modulo-/SDP-2016-Team-F/doc/group12/TechSpec/Arduino.tex

\section{Arduino Software}
\subsection{Main Loop}
The main loop listens on the serial port and executes any command received in a non-blocking manner. 
\subsection{Command Set}
The commands are as follows:\\
kick(distance)\\
grab()\\
release()\\
turn(angle)\\
move(distance)\\
\subsection{Command Response}
In response to a command the robot immediately drops what it is doing and runs that command. 
\subsection{Kicking}
The robot aligns the ball with the grabbers then releases them until they are at position 0 (fully extended) then kicks a time dependent on the distance required, then closes the grabbers to position 13 (fully closed) for continued movement. The formula for kick time in ms used by the arduino is $ 1.3*(D-46) $ where D is distance required in cm. 
\subsection{Grabbing}
The robot closes the grabbers until they are fully closed or 800ms whichever is sooner, if the grabbers only close to position 10 the grab is considered a success and this is sent to the planner. 
On success: reply "BC"
On failure: reply "NC"
\subsection{Release}
The grabbers are released to position 0. The reply "grabbersOpen" is always sent. 
\subsection{Turn}
The robot accelerates up to a calibrated turning speed, then maintains that speed until it has just enough time to decelerate to the required position. The wheels are kept turning the same distance using the distance from the rotary encoders by powering down a motor if it has gone too far and powering it up if it has not gone far enough. The turn is considered finished when the averaged distance from the left and right wheels matches the calculated distance required to rotate the desired angle (by using radius of wheels:2.5cm, radius from origin:7.5cm). 
\subsection{Move}
The robot accelerates up to the calibrated speed and then maintains that speed until it has just enough time to decelerate to the desired distance. It keeps the wheels going the same distance using the rotary encoders by reducing power to a wheel that has gone too far. The distance is determined by the
 $\texttt{radius of the wheels} \times \pi \times \texttt{rotation}$.
