modulo-/SDP-2016-Team-F/doc/group11/tech_spec/main.tex

\documentclass[a4paper,12pt]{scrartcl}
\author{Thomas Kerber, Marek Strelec, Euan Hunter}
\title{SDP Technical Specification}
\subtitle{Group 11}

\usepackage[margin=3.4cm]{geometry}
\usepackage{array}
\usepackage{tabularx}
\usepackage{enumitem}
\usepackage{paralist,array}
\usepackage{listings}
\usepackage{cleveref}
\usepackage{graphicx}
\usepackage{float}
\usepackage{caption}
\usepackage{subcaption}
\usepackage{gensymb}
\lstset{language=Python, showstringspaces=false}

\begin{document}
\maketitle

\section{Introduction}

The aim of this project was to create a robot that would play a simplified
version of 2-a-side football. We used the provided Arduino Xino RF board and
LEGO pieces, a vision feed of the pitch, and a computer to connect Arduino and
vision. This report will examine the decisions made in the design of each part
and their impacts.

\input{overview}
\input{comms}
\input{arduino}
\input{hardware}
\input{vision}

\pagebreak
\input{planner}

\pagebreak
\appendix

\input{abi}
\input{llcmd}
\input{params}
\input{goalstructure}

\end{document}
