modulo-/SDP-2016-Team-F/admin/2016-02-22.md

note that the axes should be short axis -y long axis -x and angles should be clockwise from y
people should be careful to switch to master 
blue distortion at edge of vision feed is a priority 
everyone should get a draft of their section of the reports
