modulo-/SDP-2016-Team-F/admin/expenses.md

# Expenses Group 11

| Item | Cost  | Funds From |
|--- |:----: | ---|
| | | |

Total: £0
Budget left: £100 

# Expenses Group 12

| Item | Cost  | Funds From |
|--- |:----: | ---|
| 2 Keys | £5 | Margus |
| Wheels | ??? | Garry | 
| battery holders | £5.02 | Joel | 

Total: £10.02
Budget left: £89.98
