modulo-/SDP-2016-Team-F/doc/group12/TechSpec/obstacle_avoidance.tex

\begin{tikzpicture}
  
\tikzset{
    right angle quadrant/.code={
        \pgfmathsetmacro\quadranta{{1,1,-1,-1}[#1-1]}     % Arrays for selecting quadrant
        \pgfmathsetmacro\quadrantb{{1,-1,-1,1}[#1-1]}},
    right angle quadrant=1, % Make sure it is set, even if not called explicitly
    right angle length/.code={\def\rightanglelength{#1}},   % Length of symbol
    right angle length=2ex, % Make sure it is set...
    right angle symbol/.style n args={3}{
        insert path={
            let \p0 = ($(#1)!(#3)!(#2)$) in     % Intersection
                let \p1 = ($(\p0)!\quadranta*\rightanglelength!(#3)$), % Point on base line
                \p2 = ($(\p0)!\quadrantb*\rightanglelength!(#2)$) in % Point on perpendicular line
                let \p3 = ($(\p1)+(\p2)-(\p0)$) in  % Corner point of symbol
            (\p1) -- (\p3) -- (\p2)
        }
    }
}

\node  (robot)  [draw, inner sep=5] at (0,-1) {ROBOT};
\node  (target)  [draw,inner sep=5] at (0,5) {TARGET};
\draw  (robot) [dotted, -open triangle 60] edge node [sloped, below left ]{original path} (target);

\node (obstacle)[draw] at (1,3) {$O_2$};
\draw [dashed, shorten >=-1.5cm,shorten <=-2.5cm] ($(robot)!(obstacle)!(target)$) -- (obstacle);

\draw [right angle symbol={robot}{$(robot)!(obstacle)!(target)$}{obstacle}];
\coordinate (new) at (-1.5,3) {};

\path (robot) [-triangle 60] edge node [sloped,below] {corrected path} (new)
(new) [-triangle 60] edge (target);

\draw[decorate,decoration={brace,raise=2pt,amplitude=2pt}] (obstacle)  -- node[below=3pt]{$d_{min}$} (new) ;

\end{tikzpicture}
