modulo-/SDP-2016-Team-F/doc/group12/TechSpec/Planning.tex

\section{Planning}
\lstset{language=Python, showstringspaces=false}

\subsection{Design}

The planner uses a system of goals and actions. Goals define an overall strategy in a given situation leading to a particular aim. Actions define one instruction given to the robot with preconditions for its execution. Goals are composed of a sequence of actions. A goal object selects the next action required to achieve its aim by traversing its ordered list of actions and evaluating their preconditions.

In the implementation, all goals and actions are derived from their respective super classes. These are defined as follows:

\begin{figure}[H]
	\centering
    
    \caption{Definition of super class for goals}
\end{figure}

\begin{figure}[H]
	\centering
    
    \caption{Definition of super class for actions}
\end{figure}

The planner makes its decision based only on the world state passed to it. This is described by an instance of the  class passed to the planner. This object's state is updated by passing a new set of positions (as a dictionary of vectors) to the \texttt{update\_positions} method of \texttt{World}. The \texttt{World} class describes the state of the world from the vision, including position vectors for the robots, the ball, and the goals. The \texttt{World} class and its associated classes also implement methods on their data providing the planner with information about the world. Further utility functionality can be found in ``\texttt{utils.py}''

The overall planner is used by calling \texttt{plan\_and\_act(world)}.
This selects a goal based on the given world state  using its \texttt{get\_goal()} method. From this goal an action is generated using \texttt{generate\_action()}. The method then runs (using \texttt{actuate(action)}) and returns a delay giving the time until the planner should be run again.

In order to succeed, the planner must be able to detect obstacles on the path of a robot's movement and on the path of a pass or shot on goal. Having established a location and target, the planner checks for obstacles as seen in \autoref{fig:obstacle_detection}. $O_i$ is an obstacle if ($d_i > \texttt{THRESHOLD}$).

\begin{figure}[H]
\centering
\begin{subfigure}{.5\textwidth}
\centering
\input{obstacle_detection}
\caption{Detection}
\label{fig:obstacle_detection}
\end{subfigure}%
\begin{subfigure}{.5\textwidth}
\centering
\input{obstacle_avoidance}
\caption{Avoidance}
\label{fig:obstacle_avoidance}
\end{subfigure}
\caption{Handling Obstacles}
\label{handling_obstacle}
\end{figure}

By finding the distance of each object from the path and using a constant threshold, the planner establishes whether or not, and if so which, objects will be obstacles to a given path. If an obstacle is found, the planner must, if possible, generate a new path avoiding the obstacle. This is done using the line perpendicular to the path passing through the obstacle. The planner iterates over points at fixed distances along the line, working outwards from the original path, testing for obstacles on this corrected path. This produces a minimal path avoiding the obstacle. This can be seen in \autoref{fig:obstacle_avoidance}.

The planner also incorporates logic outwith this high level design for obeying specific rules, closing the robot's grabbers after a fixed time open and releasing the ball after a fixed time holding it. These work through communication with the robot and timers running alongside the main planner thread.

\subsection{Implementation}

The attacker robot's goals and their respective actions are explained in \autoref{tbl:goals-actions}.
The planner chooses a goal based on ball position, as explained in \autoref{tbl:goals}.

\begin{table}[H]
  \centering
\begin{tabularx}{\textwidth}{l l X}
\toprule
\textbf{Goal} & \textbf{Action} & \textbf{Preconditions} \\ 
\midrule

AttackPosition & TurnToDefenderToReceive & Attacker in score zone \\ 
&GoToScoreZone & Attacker is facing score zone  \\ 
&TurnToScoreZone & None \\
\midrule

Score & Shoot & Attacker has ball and attacker can score \\ 
& TurnToGoal & Attacker has ball \\ 
\midrule

GetBall & GrabBall & Attacker can catch ball and attacker's grabbers open \\ 
& GoToGrabStaticBall & Ball static, attacker facing ball, attacker's grabbers open \\ &OpenGrabbers & Ball in attacker's grab range, attacker's grabbers closed \\ 
&GoToBallOpeningDistance & Attacker is facing ball \\
&TurnToBall & None \\ 
\midrule

AttackerBlock & TurnToBlockingAngle & Attacker in blocking position \\ 
& GoToBlockingPosition & Attacker is facing blocking position \\ 
& TurnToFaceBlockingPosition & None \\ 
\bottomrule
\end{tabularx}
\caption{Actions and Preconditions by Goals}
\label{tbl:goals-actions}
\end{table}

\begin{table}[H]
\centering
\begin{tabular}{ l l}
\toprule
\textbf{Robot in possession} & \textbf{Goal} \\ \midrule
Our attacker & Score \\
Our defender & AttackPosition \\
Their attacker & AttackPosition \\
Their defender & AttackerBlock \\
Ball free & GetBall \\ \bottomrule
\end{tabular}
\caption{Goals chosen dependent on ball position}
\label{tbl:goals}
\end{table}

\subsection{Extensibility}

Extending the planner is simply a case of adding goals and actions then adding the logic to select these in \texttt{select\_goal(world)}. Any new goals or actions should subclass Goal and Action respectively and override methods were stated.

In actions, the logic for performing should be placed in \texttt{perform(comms)}. This method is passed a \texttt{CommsManager} object through which the robot can be sent instructions. No more than one call should be made to this object in any given action. A new action should also override \texttt{get\_delay} giving an appropriate delay (in seconds) before the planner should run again. New actions can also have preconditions defined in a variable \texttt{preconditions}.

In goals, it may only be neccessary to write a Goal subclass with an ordered list of actions (from last to first). Otherwise, the \texttt{generate\_action()} method can be overriden but similar logic should be followed.

\subsection{Integration}

An instance of the \texttt{Planner} is kept by the ``main.py'' script. Based on the delays given by the planner, it calls the planner at varying intervals, passing it the latest world model provided by the vision. The planner uses a \texttt{CommsManager} object to control the robot.
