modulo-/SDP-2016-Team-F/doc/group12/TechSpec/images/DSC_0033.jpg

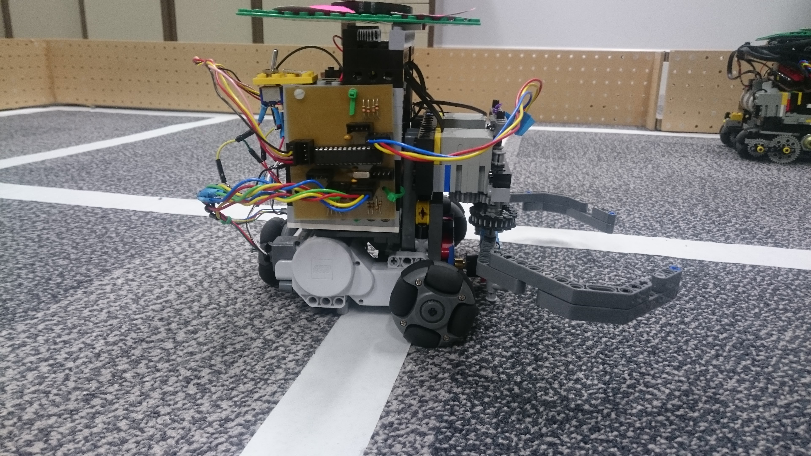
doc/group12/TechSpec/images/DSC_0033.jpg
