modulo-/SDP-2016-Team-F/doc/group12/TechSpec/images/DSC_0035.jpg

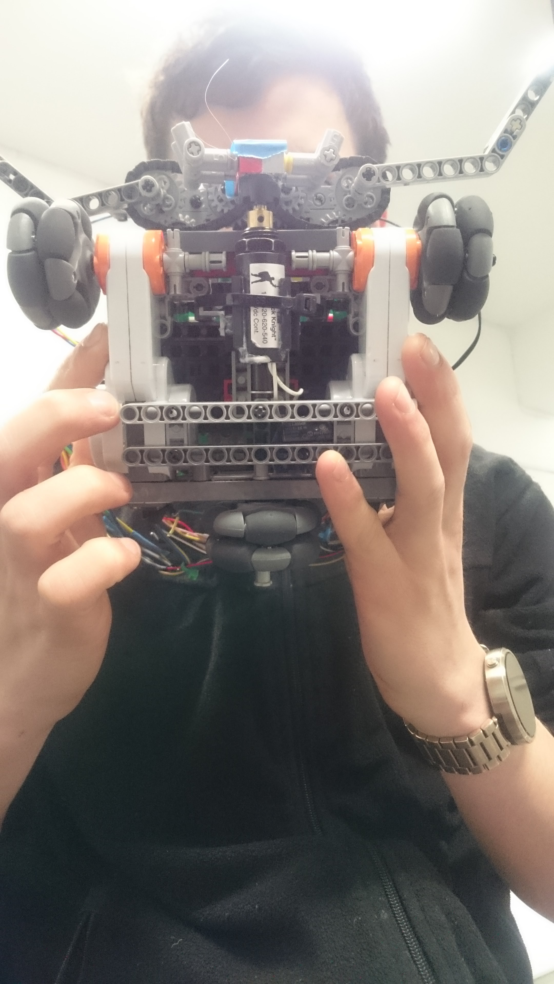
doc/group12/TechSpec/images/DSC_0035.jpg
