modulo-/SDP-2016-Team-F/doc/group12/TechSpec/images/obstacle_detection.jpg

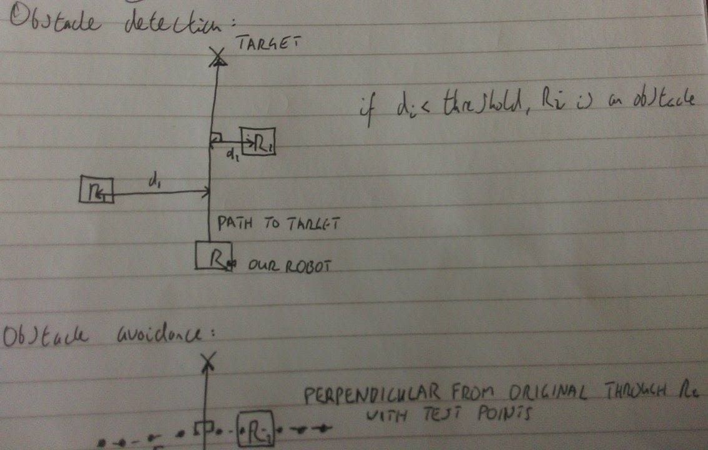
doc/group12/TechSpec/images/obstacle_detection.jpg
