modulo-/SDP-2016-Team-F/doc/group12/TechSpec/images/speed_time.png

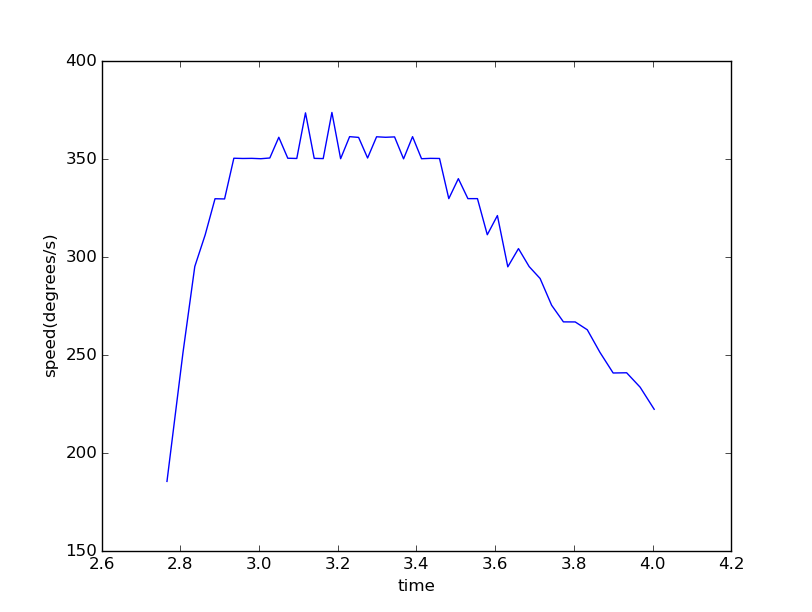
doc/group12/TechSpec/images/speed_time.png
