modulo-/SDP-2016-Team-F/plot/acceleration_time.png

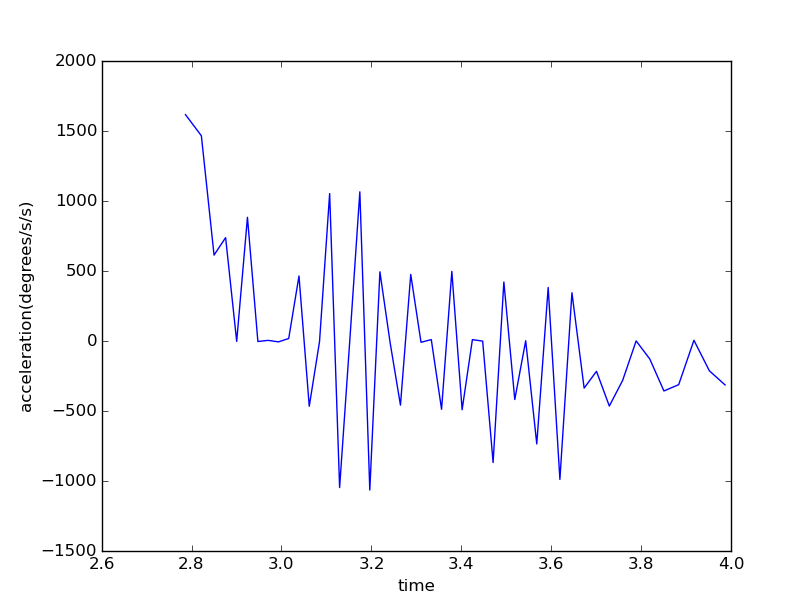
plot/acceleration_time.png
