modulo-/SDP-2016-Team-F/plot/difference_time.png

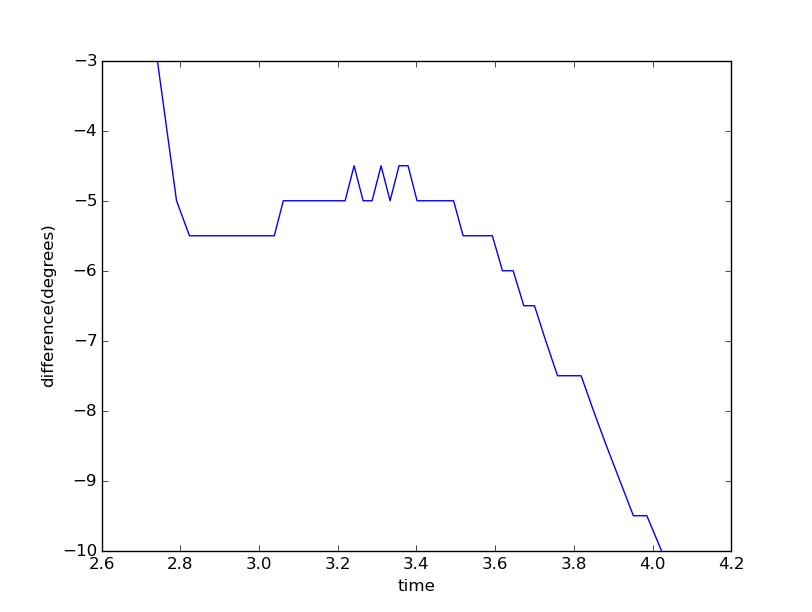
plot/difference_time.png
