modulo-/SDP-2016-Team-F/plot/distance_time.png

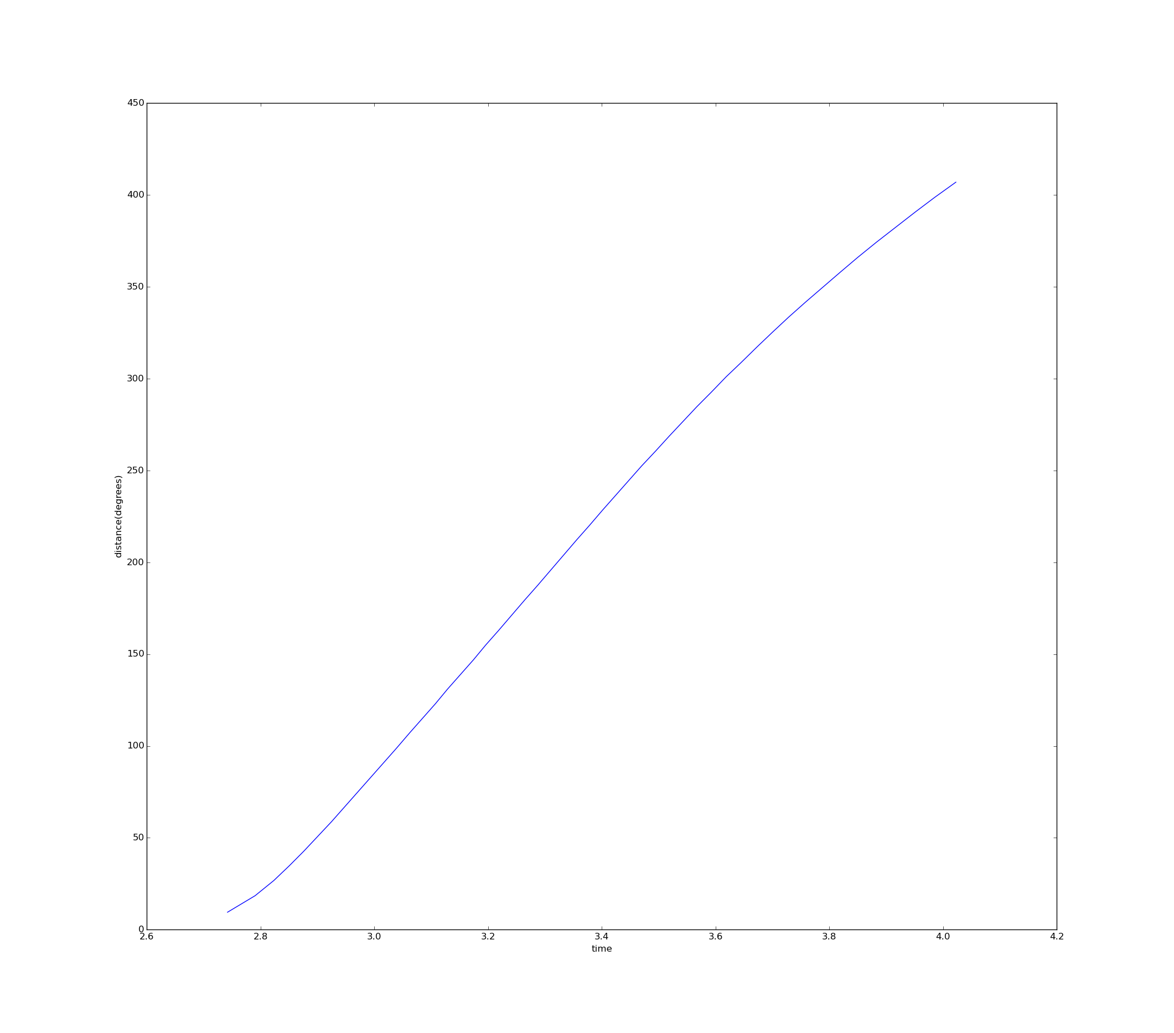
plot/distance_time.png
