modulo-/SDP-2016-Team-F/vision-euan/config/pitch303-background.png

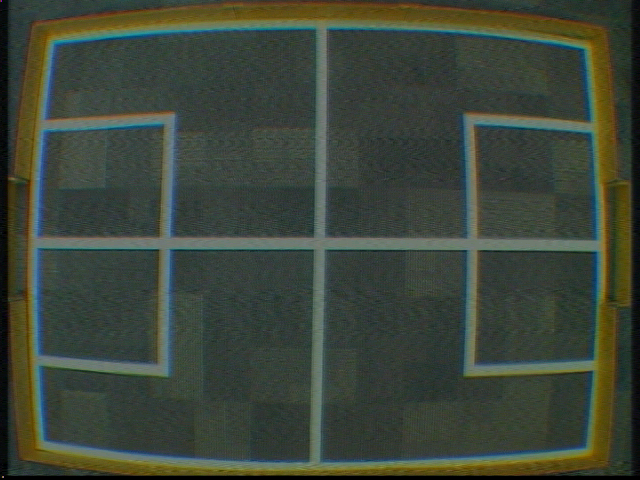
vision-euan/config/pitch303-background.png
