modulo-/SDP-2016-Team-F/vision-euan/config/pitch304-background.png

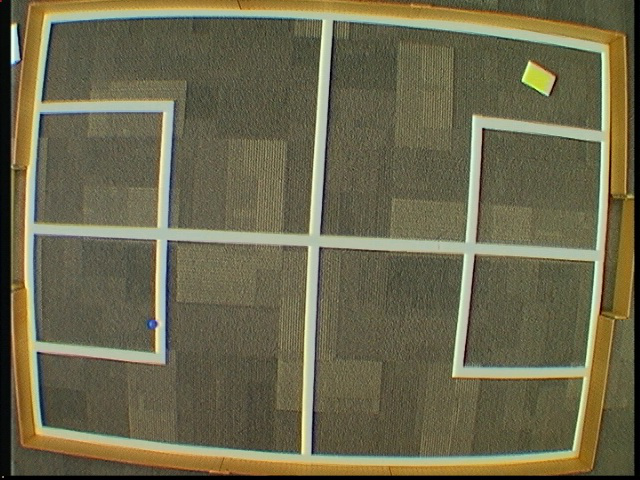
vision-euan/config/pitch304-background.png
