modulo-/SDP-2016-Team-F/Vision/preprocessing/re/3800_9x6.png

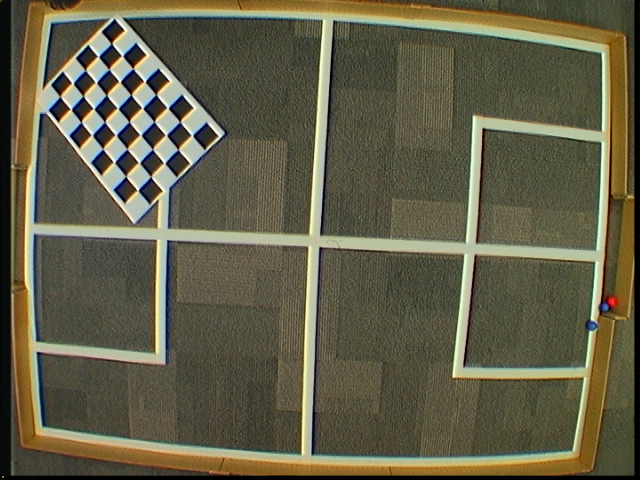
Vision/preprocessing/re/3800_9x6.png
