modulo-/SDP-2016-Team-F/doc/group12/UserGuide/UserGuide.tex

\documentclass[12pt,a4paper]{article}
\usepackage[utf8]{inputenc}
\usepackage{amsmath}
\usepackage{amsfonts}
\usepackage{amssymb}
\usepackage{graphicx}
\usepackage{float}
\usepackage{subcaption}

\usepackage{tabularx}

\usepackage{listings}
\usepackage[left=2cm,right=2cm,top=2cm,bottom=2cm]{geometry}

\newcommand{\shellcmd}[1]{\indent\indent\texttt{\footnotesize\# #1}}

\usepackage[hypcap]{caption}
\usepackage[pdfusetitle, hidelinks]{hyperref}
\hypersetup{ 
    bookmarksnumbered=true,     
    bookmarksopen=true,         
    bookmarksopenlevel=2,         
    pdfstartview=Fit,           
    pdfpagemode=UseOutlines,    % this is the option you were lookin for
    pdfpagelayout=SinglePage
    }
    
\usepackage{booktabs}
\renewcommand{\arraystretch}{1.3} 
\renewcommand{\heavyrulewidth}{0.1em} 
\usepackage{enumitem}
\graphicspath{{images/}}

\author{SDP Group 12}
\title{User Guide}

\begin{document}
\maketitle

%User Guide No more than 6 pages, worth 10 (out of 50) marks

%Reports have three purposes: to provide sufficient information to assess your work; to document for the group and yourself your design and what you have done; and to provide useful information for anyone who wants to build on what you have done in future. Reports may contain detailed appendices beyond the page limit, particularly in aid of the last two goals; but markers are not required to read these appendices. A common mistake is to overuse the appendices— figures, tables, or other material that explains your work belongs in the main report, not an appendix. Large illustrations will not count towards the page limits.

\section{Starting the System}

In order to start the robot: 

\begin{itemize}
    \item place a charged set of batteries in the back holder, and connect it to the Arduino power cable
    \item plug the RF stick in the computer, ensuring all top plates and the ball are on the pitch
    \item execute `\texttt{python main.py -p <PLAN> -1 <PATH> -c <COLOR> -g <GOAL>}', where,
    \begin{itemize}[label=$\circ$]
        \item \texttt{<PLAN>} is the plan to run (see section 1.1 below),
        \item \texttt{<PATH>} is the device path of the RF stick (e.g. `\verb$/dev/ttyACM0$'),
        \item \texttt{<COLOR>} is the team color, which must be either `\texttt{blue}', `\texttt{b}', `\texttt{yellow}', or `\texttt{y}',
        \item \texttt{<GOAL>} is controlled team's goal end, either `\texttt{left}' or \texttt{right}'.
    \end{itemize}
    \item logging level and verbosity can be set with the following additional options:
    \begin{itemize}[label=$\circ$]
        \item `\texttt{--debug}' or `\texttt{-l debug}',
        \item `\texttt{--info}' or `\texttt{-l info}',
        \item `\texttt{--warn}' or `\texttt{-l warn}',
        \item `\texttt{--error}' or `\texttt{-l error}'.
    \end{itemize}
    \end{itemize}

While the control program is running, the overall strategy and logging can be modified. Entering a plan name and pressing enter switches the running plan to the new plan that has been entered. Entering `\texttt{stop}' unsets the active plan and leaves the robot idle.

\input{Planning}

\input{Vision}

\input{Hardware}

\end{document}
