modulo-/SDP-2016-Team-F/doc/group12/UserGuide/images/DSC_0147.jpg

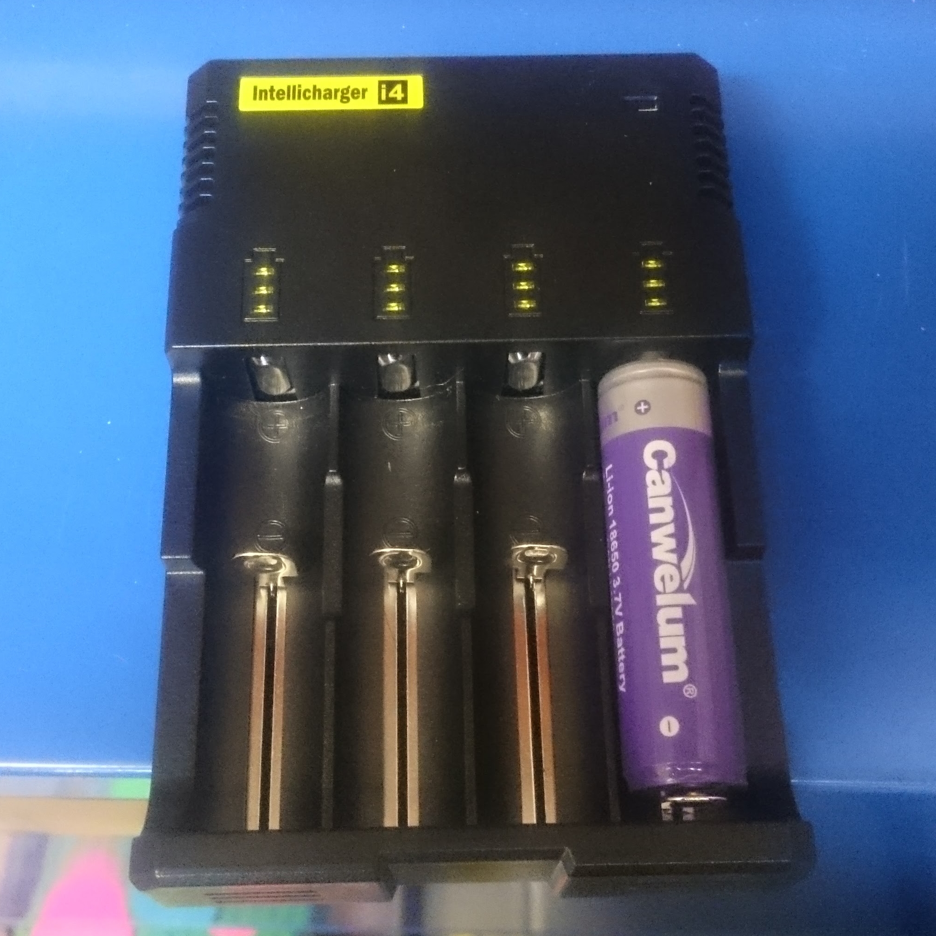
doc/group12/UserGuide/images/DSC_0147.jpg
