modulo-/SDP-2016-Team-F/src/group11cmd.py

#!/usr/bin/python2
from __future__ import division
from comms import SerialHandle
import sys
from math import ceil, atan, sqrt, pi
import logging
from logging import debug, error
import readline

CMD_WAIT          = 0x00
CMD_BRAKE         = 0x01
CMD_STRAIT        = 0x02
CMD_SPIN          = 0x03
CMD_KICK          = 0x04
CMD_MV            = 0x05
CMD_GRABBER_OPEN  = 0x06
CMD_GRABBER_CLOSE = 0x07
CMD_HOLD_SPIN     = 0x08
CMD_SPD_SET       = 0x09
CMD_ARC           = 0x0a

class TractorCrabException(Exception):
    def __init__(self, s):
        super(Exception, self).__init__(s)

class Command:
    def __init__(self, f, desc, argl):
        self.f = f
        self.desc = desc
        self.argl = argl

def i16fn(opcode):
    return lambda x: [opcode, x & 0xff, (x >> 8) & 0xff]

cmd_wait = i16fn(CMD_WAIT);
cmd_brake = i16fn(CMD_BRAKE)
cmd_strait = i16fn(CMD_STRAIT)
cmd_spin = i16fn(CMD_SPIN)
cmd_kick = i16fn(CMD_KICK)
cmd_grabber_open = lambda: [CMD_GRABBER_OPEN]
cmd_grabber_close = lambda: [CMD_GRABBER_CLOSE]
cmd_hold_spin = i16fn(CMD_HOLD_SPIN)
cmd_spd_set = lambda x: [CMD_SPD_SET, x & 0xff]
cmd_arc = lambda x, y: [CMD_ARC, x & 0xff, (x >> 8) & 0xff, y & 0xff, (y >> 8) & 0xff]

def cmd_mv(x0, y0, angle0, x1, y1, angle1):
    return [CMD_MV,
        x0 & 0xff, (x0 >> 8) & 0xff,
        y0 & 0xff, (y0 >> 8) & 0xff,
        angle0 & 0xff, (angle0 >> 8) & 0xff,
        x1 & 0xff, (x1 >> 8) & 0xff,
        y1 & 0xff, (y1 >> 8) & 0xff,
        angle1 & 0xff, (angle1 >> 8) & 0xff]

def parse_t(s):
    t = int(s)
    if t <= 0:
        raise TractorCrabException('Time must be > 0!')
    elif t > 0xffff:
        raise TractorCrabException('Time out of range!')
    return t

def parse_dist(s):
    d = int(float(s) * 10)
    if d < -0x8000 or d > 0x7fff:
        raise TractorCrabException('Distance out of range!')
    return d

def parse_angle(s):
    d = int(float(s) * 60)
    if d < -0x8000 or d > 0x7fff:
        raise TractorCrabException('Angle out of range!')
    return d

def parse_spd(s):
    d = int(s)
    if d < 0 or d > 0xff:
        raise TractorCrabException('Speed out of range!')
    return d

commands = {
    'wait': Command(cmd_wait, 'waits for the specified time',
        [('time', parse_t)]),
    'brake': Command(cmd_brake,
        'brakes for the specified time',
        [('time', parse_t)]),
    'strait': Command(cmd_strait,
        'moves strait (positive: right) the specified distance',
        [('dist', parse_dist)]),
    'spin': Command(cmd_spin,
        'Spins on the spot the specified angle (positive: clockwise)',
        [('angle', parse_angle)]),
    'kick': Command(cmd_kick,
        'Kicks the ball the specified time',
        [('time', parse_t)]),
    'mv': Command(cmd_mv,
        'Moves to a x and y offset, facing a specified angle',
        [('x0', parse_dist), ('y0', parse_dist), ('angle0', parse_angle),
         ('x1', parse_dist), ('y1', parse_dist), ('angle1', parse_angle)]),
    'grabber_open': Command(cmd_grabber_open,
        'Opens the grabbers',
        []),
    'spd_set': Command(cmd_spd_set,
        'Set the speed',
        [('speed', parse_spd)]),
    'arc': Command(cmd_arc,
        'Moves in an arc',
        [('dist', parse_dist), ('radius', parse_dist)]),
    'grabber_close': Command(cmd_grabber_close,
        'Closes the grabbers',
        []),
    'hold_spin': Command(cmd_hold_spin,
        'Spins on the spot the specified angle (positive: clockwise), ' +
        'holding the ball in place.',
        [('angle', parse_angle)]),
}

def help_cmd(cmd):
    if cmd not in commands:
        print "No entry for '{}'.".format(cmd)
        return
    parts = [cmd]
    for arg in commands[cmd].argl:
        parts.append('<' + arg[0] + '>')
    print ' '.join(parts)
    print ''
    print commands[cmd].desc

def help_cmds():
    print "Commands available:"
    print ""
    cmdnames = list(commands.keys())
    cmdnames.extend(['help', 'exit'])
    cmdnames.sort()
    print ', '.join(cmdnames)
    print ""
    print "Run 'help <cmd>' for more details about '<cmd>'."
    print "Commands are run in a shell-like style, and take arguments"
    print "sererated with spaces. (e.g. 'wait 100')"
    print ""
    print "Commands take a fixed number of arguments, and may be chained in"
    print "sequence (e.g. strait 100 strait -100)."
    print ""
    print "Distances are measured in mm, angles in degrees and times in ms."
    print ""
    print "Commands which cannot be used in a chain are 'help' and 'exit'."

def run(cmdbytes):
    comms.stop_resend('')
    comms.send(''.join(chr(x) for x in cmdbytes), '1')

if __name__ == '__main__':
    logging.root.setLevel(logging.DEBUG)
    if len(sys.argv) < 2:
        error('RF device not specified')
        print "Please provide the RF device as an argument (e.g. '/dev/ttyACM0')"
    else:
        comms = SerialHandle(sys.argv[1], '60', '~~~')
        print "Comms system online. Type 'help' for command information."
        print ""
        print "time is given in milliseconds. Please wait for a command to complete before sending a new one."
        print "commands aside from 'exit' may be chained. E.g.:"
        print ""
        print "kicker_extend_t 500 wait_t 1000 kicker_retract_t 500"
        print ""
        print "Please use this responsibly, packets are limited in effective size!"
        while True:
            try:
                line = raw_input('% ')
                args = line.split()
                i = 0
                if len(args) == 0:
                    continue
                elif args[0] == 'exit':
                    exit(0)
                elif args[0] == 'help':
                    if(len(args) >= 2):
                        help_cmd(args[1])
                    else:
                        help_cmds()
                    continue
                cmdbytes = []
                while i < len(args):
                    if args[i] not in commands:
                        raise TractorCrabException("Unknown command: '" + args[i] + "'")
                    cmd = commands[args[i]]
                    cmd_arglen = len(cmd.argl)
                    if len(args) < cmd_arglen + i + 1:
                        raise TractorCrabException('Too few arguments!')
                    cmd_args = args[i + 1 : i + 1 + cmd_arglen]
                    parsed_args = []
                    for (argspec, arg) in zip(cmd.argl, cmd_args):
                        parsed_args.append(argspec[1](arg))
                    cmdbytes.extend(cmd.f(*parsed_args))
                    i += cmd_arglen + 1
                if cmdbytes:
                    debug('Sent command sequence %r', cmdbytes)
                    comms.send(''.join(chr(x) for x in cmdbytes), '1')
            except TractorCrabException as e:
                error('%s', e)
