modulo-/SDP-2016-Team-F/(commit log)

2016-01-17 v0.1 Main Arduino code, a very empty "template"
2016-01-18 maybe make arduino libs link (more) correctly
2016-01-18 How-to: RF config and arduino libs
2016-01-18 added some debug to the motor testing
2016-01-19 Thomas's design schematic
2016-01-19 Avoid .swp files from Arduino IDE
2016-01-19 Update to current wiring. make sure going straight stops turning
2016-01-19 Free /arduino/test.
2016-01-19 Change naming scheme to be closer to the arduino one, add tests to gitignore.
2016-01-19 Fix code so that the arduino IDE compiles it.
2016-01-20 Arduino debug dir
    Create debug dir and move manual control of motors to debug dir. Last
    part of fix for #1
2016-01-20 Lay down header file for arduino comms library.
2016-01-21 Add test arduino program.
2016-01-21 Move motor test scripts to debug dir
2016-01-21 Add adafruid sensor libs
2016-01-22 initial Milestone 1 arduino code
2016-01-22 Fix a lot of bugs, some way still to go.
    [b64.py, comms.py]
2016-01-22 Fix stuff on arduino side.
2016-01-22 added kicker calibration routine
2016-01-22 kicker calibration, inc notes on powers for distances
2016-01-22 added kicker calibration to milestone1 branch
2016-01-22 added rotation calibration (coarse)
2016-01-23 Fix command tester thingy, add command chaining functionality, which is not tested but *should* work.
    [group11cmd.py]
2016-01-24 added distance calibration script
2016-01-24 Added drift correction to distance calibration
2016-01-25 more fiddling with distance calibration
2016-01-25 Get arduino code close to completion for milestone 1.
2016-01-26 Move kicker calibration to dedicated .ino
2016-01-27 Late night bullshit calibrations push.
2016-01-27 Motorbrake support
    Not sure if this has any positive effect
2016-01-31 Work on basic structure of rotary-encoder based movement.
2016-02-02 Add spin, calibrate with rotary encoders.
2016-02-03 Add break command, adjust calibration to assume break after, do not use adjusted powers for spinning.
2016-02-03 Initial commit with unstructured mess of prototype code.
2016-02-04 Moved old prototype code to old directory
2016-02-04 Switched compilation process from messy CMake to simple bash script
2016-02-04 'From Scratch' vision system v0.0.1:
    Can detect ball and all but the yellow marker most of the time.
    Colours and other parameters are complete guesses and need calibrated
    and tweaked.
    Camera distortion has not been fixed yet.
    [main.cpp]
2016-02-05 Replaced HoughCircles with a combination of findContours and convexHull for circle detection. Gives much more control over detection.
    Seems to work on static objects with only a few false positives (which can
    be removed by further checking if the object is remotely circular).
    Struggles on moving objects, but this is likely due to the camera
    distortion.
    Colours are still guesses so doesn't work 100%.
    [main.cpp]
2016-02-05 Replaced convexHull detection with custom method using minEnclosingCircle and fitEllipse.
    [main.cpp]
2016-02-06 god knows what, but Vision/vision.py can detect robots and balls (not robor orientation).
    Screw you guys, I'm going home
2016-02-06 reset gitignore to filter out files~
2016-02-06 fix filters
2016-02-07 Removed old code and old calibration data.
2016-02-07 Added rough manual (via trial-and-error) camera calibration data (human readable)
2016-02-07 Added Pitch, Camera and Config classes. (My C++ is terrible, so these probably do something wrong).
    [Camera.cpp, Camera.h, Config.cpp, Config.h, Pitch.cpp, Pitch.h]
2016-02-07 Updated to use new classes, to use background subtraction and be generally a bit tidier. KNOWN ISSUE: Tracking currently has problems with the white lines on the pitch.
    [main.cpp]
2016-02-07 Fix stuff, add grabbers, add hold and spin.
    [group11cmd.py, hlcmd.cpp, llcmd.cpp, llcmd.h]
2016-02-07 Replaced method used for background subtraction. Fixes the issue detection was having with the white lines on the pitch.
    [main.cpp]
2016-02-08 Re-calibrate, come some debug output to properly use debug logger.
2016-02-08 Recalibrated pitch 3.03.
2016-02-08 Updated representation of coloured circles and robots. Updated colour calibration. Added rudimentary robot identification, position and orientation calculation.
2016-02-08 Add milestone 2 goal values (based on given current task) to planner
2016-02-08 Updated pitch 3.03 background image.
2016-02-08 Added named pipe JSON output (currently piecemeal and horrible, but working.
    Fixed orientation line drawing.
    Code format.
    [Config.cpp, main.cpp]
2016-02-09 Attempt to integrate with (currently broken) planner.
    [comms.py, group11cmd.py]
2016-02-09 Make move-and-grab, with *some* margin of error, and simulate
    [comms.py]
2016-02-09 version of rotation for three wheels without acceleration
2016-02-09 support for multiple colour calibrations NOT TESTED
2016-02-09 Added camera parameter setting to Camera class.
2016-02-09 Use new kicker pin, correct worldmodel.
    [group11.ino, llcmd.cpp]
2016-02-09 Start of attempt to rework vision system to be 'top-down'.
    [main.cpp]
2016-02-09 Fixed JSON output. Added circles drawing debug code.
    [main.cpp]
2016-02-09 Added 'anti-flicker' to UI to reduce how noticeable the vision system not finding an object for a single frame is.
2016-02-10 Fixed orientation calculation (hopefully).
    [main.cpp]
2016-02-10 Fixed again. (forgot radians are a thing)
    [main.cpp]
2016-02-10 Fixed orientation calculation AGAIN (this time, forgot you have to init a vector before you use it, not afterwards).
    [main.cpp]
2016-02-10 Fixed orientation for all other patterns.
    [main.cpp]
2016-02-10 Added temporary fix for pink-ball issue.
    [main.cpp]
2016-02-10 Add vision thread and correct timer to main script
    [main.py]
2016-02-10 Fix angle name in comms turn
    [comms.py]
2016-02-10 Attempt at fixing yellow detection problem and pink-ball problem.
    [main.cpp]
2016-02-10 Fix has_ball grabber case bug
2016-02-10 Fix catcher bug and switch sign of relative angles
2016-02-19 Fix main.py, replacing our_robot with our_defender
    [main.py]
2016-02-19 Use logging instead of prints, allow new commands to be sent.
2016-02-19 Fix some stuff, make threads daemonic and add logging control.
    [main.py]
2016-02-20 Extract common rotation code and remove print statements
2016-02-22 Fix various minor issues.
    [main.py]
2016-02-25 Change format, track time.
2016-02-25 Added camera parameter setting.
2016-02-26 Added automatic mouse color calibration
2016-02-26 Added sample file with recorded calibrations
2016-02-27 Fix grabbers (the direction reversed! wtf?)
    [hlcmd.cpp, llcmd.cpp]
2016-02-27 Make it not crash anymore.
    [main.py]
2016-02-28 Fixed automatic calibration to work in both pitches. Added checks to deal with blue distortion.
2016-02-28 Fix vision calibration for main.py
2016-02-29 Add the color calibrations file to gitignore.
2016-02-29 Fix pitch number use in vision.py
2016-02-29 Better weighting, velocity calculation in predictor.
2016-02-29 Add interrupts, track opponent robots.
2016-03-01 Implement follow ball, add turn-and-move, add tons of FIXMEs.
    [comms.py]
2016-03-02 Fix more bugs and add more accurate pitch dimensions
2016-03-02 Kick it snap it
    [comms.py]
2016-03-07 Add modified comms + arduino stuff.
2016-03-08 added debug to arduino, added a script to manually send commands
2016-03-08 Allow /dev/null dummy RF stick, fix minor bug.
    [comms.py, main.py]
2016-03-09 Calibrate for the Phoenix-Tractor-Crab.
2016-03-10 Add pitch number option.
2016-03-11 Adjusted red threshold for easier ball calibration
2016-03-14 Add switch sides command.
2016-03-14 Lay groundwork for goal switching, mostly ready.
2016-03-14 Add framework for passing.
2016-03-14 Add return to defence area to goal switcher.
2016-03-14 Rename play game state to normal-play, to avoid clash with play plan.
    [main.py]
2016-03-14 Correct game state setting.
    [main.py]
2016-03-14 Integrate ball in grabbers into planner and fix some stuff
    [comms.py, main.py]
2016-03-15 Seperate attack and defence timers, allow interrupts to reset the timer. Add intercept interrupt.
    [main.py]
2016-03-15 commented out lines possibly causing bug
    [comms.py, control.ino]
2016-03-15 Fix update grabber state in main.py
    [main.py]
2016-03-15 Fix new_grabber_state and comment out attacker interrupt
    [main.py]
2016-03-23 added some fancy motor control
2016-03-24 fine tuning of obstacle avoidance
    [comms.py, control.ino, main_manual.py]
2016-03-24 Fix game state display not updating.
    [main.py]
2016-03-28 Fix logging in RFComms
    [comms.py]
2016-03-28 fixed integer overflow and out of bounds errors, added response to opening grabbers (at Hugh's request)
    [control.ino]
2016-03-28 Add new group 11 calibrations part 1.
2016-03-29 Add close grabbers timer
2016-03-29 Part-way non-linear calibration.
2016-03-29 Part 2: non-linear calibrations.
2016-03-30 Add better pitch line constants
2016-03-30 New goal picker and (possibly) fix some stuff.
    [main.py]
2016-03-30 Add top and bottom pitch bounds and fix score zone finding
2016-03-30 Increased grabbing power
2016-03-31 Group 11 last minute fixes.
    [main.py]
2016-04-01 Remove print from main.py
2016-04-01 Add room 1 pitch calibrations and blocking position movement with obstacle
2016-04-05 Start (re)documenting arduino stuff.
2016-04-06 Finish arduino part.
2016-04-19 fix images, and have schematics a ssubfigures side by side
2016-04-20 Add calibrations table to planning user guide
